n6garcia/Team-12-Documentation/motor-plate.SLDPRT

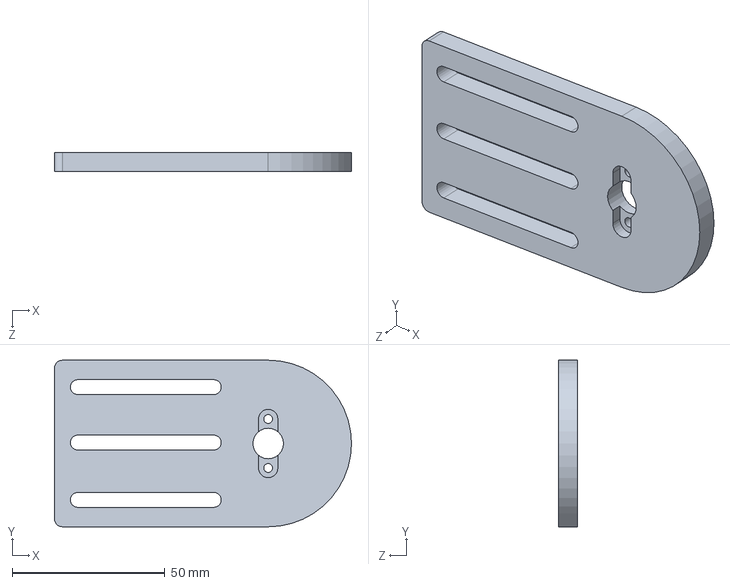
[picture p13: CAD file, 2018-12-02]
motor-plate.SLDPRT
97.1 x 54.5 x 6.35 mm
