n6garcia/Team-12-Documentation/QP_Motormount1.SLDPRT

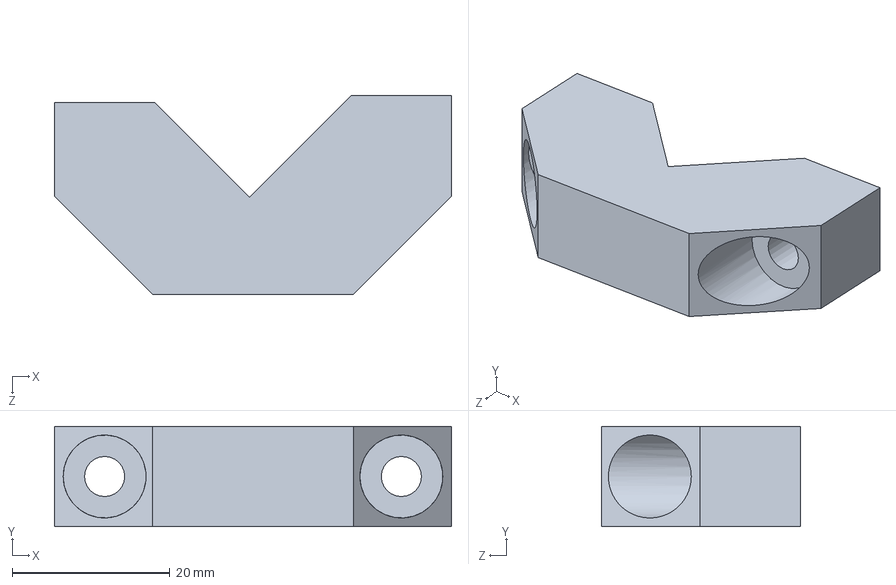
[picture p14: CAD file, 2018-12-02]
QP_Motormount1.SLDPRT
50.3 x 12.7 x 25.1 mm
