n6garcia/Team-12-Documentation/QP_Motormount2.SLDPRT

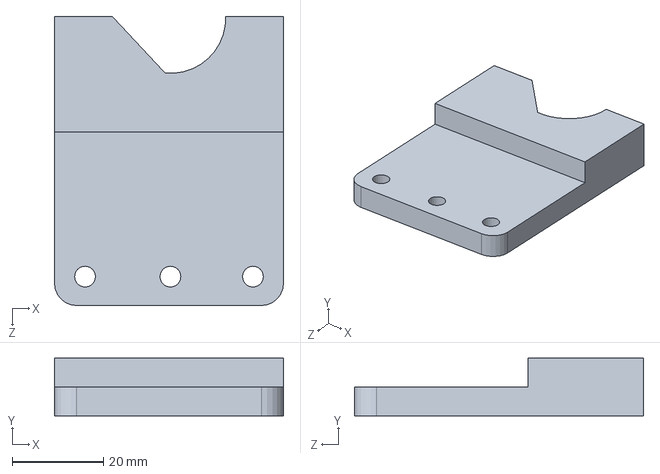
[picture p15: CAD file, 2018-12-02]
QP_Motormount2.SLDPRT
50.3 x 12.7 x 63.5 mm
