n6garcia/Team-12-Documentation/QP_Gear1.SLDPRT

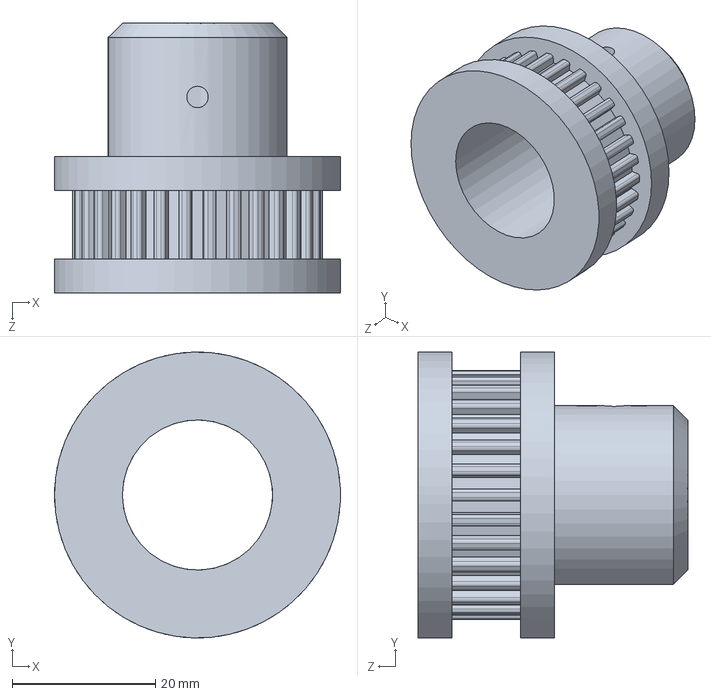
[picture p16: CAD file, 2018-12-02]
QP_Gear1.SLDPRT
40.0 x 40.0 x 37.7 mm
