n6garcia/Team-12-Documentation/QP_Gear2.SLDPRT

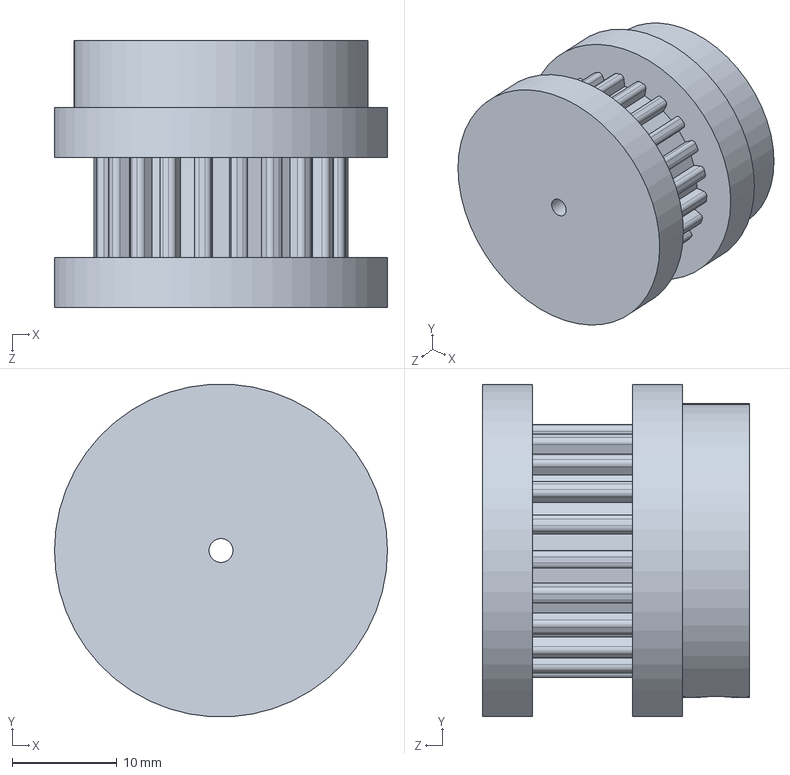
[picture p17: CAD file, 2018-12-02]
QP_Gear2.SLDPRT
31.8 x 31.7 x 25.4 mm
